BLE-MIOTY-LOCALISATION/Bluetooth-and-Mioty-Localization/README.md

This repository contains all the files related to research projects.
