BLE-MIOTY-LOCALISATION/Bluetooth-and-Mioty-Localization/NOTES.docx

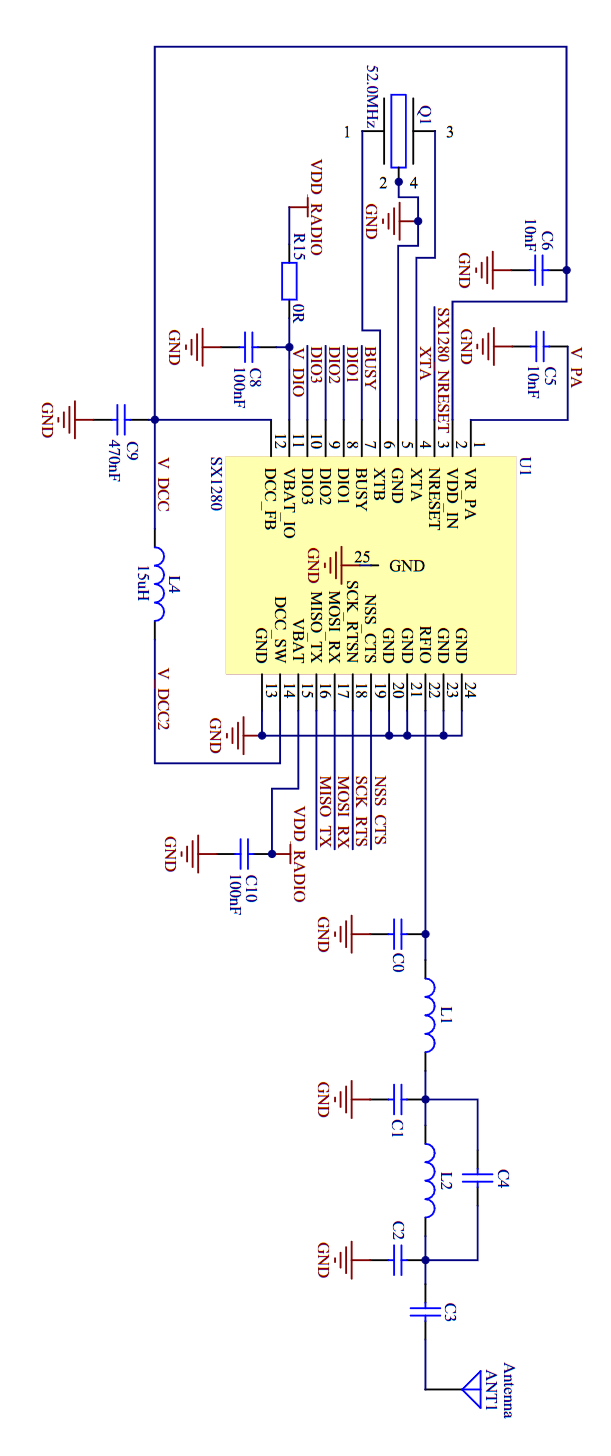
[picture p1: figure]
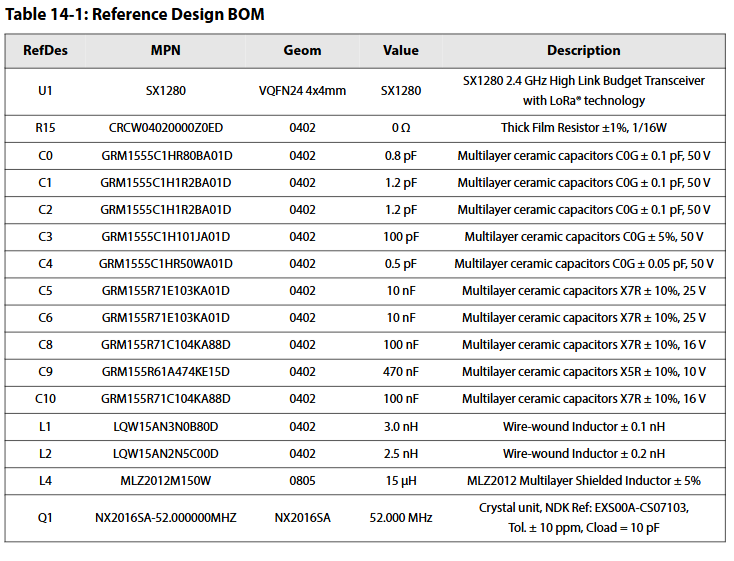
[picture p2: figure]
