BLE-MIOTY-LOCALISATION/Bluetooth-and-Mioty-Localization/BOM.xlsx

S. No. | Schematic No | Component | Details | Part number | URL | Price
Power Supply
1 | RB1 | Resistor | 20 | CRCW040220R0FKED | https://www.digikey.de/de/products/detail/vishay-dale/CRCW040220R0FKED/1177811
2 | U3 | CR2032 | Battery | CR2032 | https://www.digikey.de/de/products/detail/jauch-quartz/CR2032/13540138
Reset Mechanism
1 | R3 | Resistor | 10K | CRCW040210K0FKED | https://www.digikey.de/en/products/detail/vishay-dale/CRCW040210K0FKED/1178121
2 | C6 | Capacitor | 1u | C0402C105K8PACTU | https://www.digikey.de/en/products/detail/kemet/C0402C105K8PACTU/3471488
J Link
1 | C1 | Capacitor | 0.1u | CC0402KRX7R9BB104 | https://www.digikey.de/en/products/detail/yageo/CC0402KRX7R9BB104/5883371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
Oscillator
1 | Y1 | Crtystal Osc | 8MHx | ECS-80-12-33-JGN-TR | https://www.digikey.de/en/products/detail/ecs-inc/ECS-80-12-33-JGN-TR/10478769
2 | Y2 | Crtystal Osc | 32KHz | ABS07-32.768KHZ-7-T | https://www.digikey.de/en/products/detail/abracon-llc/abs07-32-768khz-7-t/1236859
3 | C2 | Capacitor | 24p | GRM1555C1H240GA01D | https://www.digikey.de/de/products/detail/murata-electronics/GRM1555C1H240GA01D/3693952
4 | C3 | Capacitor | 24p | GRM1555C1H240GA01D | https://www.digikey.de/de/products/detail/murata-electronics/GRM1555C1H240GA01D/3693952
5 | C4 | Capacitor | 14p | GJM1555C1H140GB01D | https://www.digikey.de/de/products/detail/murata-electronics/GJM1555C1H140GB01D/6606072
6 | C5 | Capacitor | 14p | GJM1555C1H140GB01D | https://www.digikey.de/de/products/detail/murata-electronics/GJM1555C1H140GB01D/6606072
LED
1 | R4 | Resistor | 2K | CRCW04022K00FKED | https://www.digikey.de/en/products/detail/vishay-dale/CRCW04022K00FKED/1178039
2 | D1 | LED | Blue | XL-1005UBC | https://www.digikey.de/en/products/detail/xinglight/XL-1005UBC/25673346
Microcontroller
1 | U3 | Microcontroller |  | STM32F103CBU6 | https://www.digikey.de/en/products/detail/stmicroelectronics/STM32F103CBU6/3087769
2 | R5 | Resistor | 100K | CRCW0402100KFKED | https://www.digikey.de/en/products/detail/vishay-dale/CRCW0402100KFKED/1178235
3 | C8 | Capacitor | 0.1u | CC0402KRX7R9BB104 | https://www.digikey.de/en/products/detail/yageo/CC0402KRX7R9BB104/5883371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
4 | C9 | Capacitor | 0.1u | CC0402KRX7R9BB104 | https://www.digikey.de/en/products/detail/yageo/CC0402KRX7R9BB104/5883371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
5 | C10 | Capacitor | 0.1u | CC0402KRX7R9BB104 | https://www.digikey.de/en/products/detail/yageo/CC0402KRX7R9BB104/5883371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
6 | C11 | Capacitor | 0.1u | CC0402KRX7R9BB104 | https://www.digikey.de/en/products/detail/yageo/CC0402KRX7R9BB104/5883371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
7 | C13 | Capacitor | 0.1u | CC0402KRX7R9BB104 | https://www.digikey.de/en/products/detail/yageo/CC0402KRX7R9BB104/5883371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
8 | C15 | Capacitor | 0.1u | CC0402KRX7R9BB104 | https://www.digikey.de/en/products/detail/yageo/CC0402KRX7R9BB104/5883371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
LoRa WAN Module
1 | XTAL1 | Crytal oscillator | 52M | CS06016-52M | https://www.digikey.de/de/products/detail/ndk-nihon-dempa-kogyo-co-ltd/CS06016-52M/9172036
2 | C17 | Capacitor | 10p | GRM1555C1H100FA01D | https://www.digikey.de/de/products/detail/murata-electronics/GRM1555C1H100FA01D/2543854
3 | C18 | Capacitor | 10p | GRM1555C1H100FA01D | https://www.digikey.de/de/products/detail/murata-electronics/GRM1555C1H100FA01D/2543854
4 | L3 | Inductor | 15u | MLZ2012M150W | https://www.digikey.de/en/products/detail/tdk-corporation/MLZ2012M150WT000/2465154
5 | C25 | Capacitor | 10n | GRM155R71E103KA01D | https://www.digikey.de/en/products/detail/murata-electronics/grm155r71e103ka01d/587223
6 | C27 | Capacitor | 100n | GRM155R71C104KA88D | https://www.digikey.de/en/products/detail/murata-electronics/GRM155R71C104KA88D/675947
7 | RZ1 | Resistor | 0n | CRCW04020000Z0ED | https://www.digikey.de/en/products/detail/vishay-dale/CRCW04020000Z0ED/1177495
8 | C32 | Capacitor | 100n | GRM155R71C104KA88D | https://www.digikey.de/en/products/detail/murata-electronics/GRM155R71C104KA88D/675947
9 | C30 | Capacitor | 10n | GRM155R71E103KA01D | https://www.digikey.de/en/products/detail/murata-electronics/grm155r71e103ka01d/587223
10 | C28 | Capacitor | 470n | GRM155R61A474KE15D | https://www.digikey.de/en/products/detail/murata-electronics/GRM155R61A474KE15D/702528
11 | U4 | Lora Wan |  | SX1280IMLTRT | https://www.digikey.de/en/products/detail/semtech-corporation/SX1280IMLTRT/7203797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
Antenna Frontend
1 | C19 | capacitor | 0.8p | GRM1555C1HR80BA01D | https://www.digikey.de/en/products/detail/murata-electronics/GRM1555C1HR80BA01D/3694062
2 | L1 | Inductor | 3n | LQW15AN3N0B80D | https://www.digikey.de/en/products/detail/murata-electronics/LQW15AN3N0B80D/4905926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
3 | C21 | capacitor | 1.2p | GRM1555C1H1R2BA01D | https://www.digikey.de/en/products/detail/murata-electronics/GRM1555C1H1R2BA01D/3693934
4 | C22 | capacitor | 0.5p | GRM1555C1HR50WA01D | https://www.digikey.de/en/products/detail/murata-electronics/GRM1555C1HR50WA01D/3694056
5 | L2 | Inductor | 2.5n | LQW15AN2N5C00D | https://www.digikey.de/en/products/detail/murata-electronics/LQW15AN2N5C00D/2594887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
6 | C23 | capacitor | 1.2p | GRM1555C1H1R2BA01D | https://www.digikey.de/en/products/detail/murata-electronics/GRM1555C1H1R2BA01D/3693934
7 | C26 | capacitor | 0
8 | J1 | Connector |  | CONMHF1-SMD-G-T | https://www.digikey.de/de/products/detail/te-connectivity-linx/CONMHF1-SMD-G-T/15293397?gclsrc=aw.ds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
9 | C28 | capacitor | 0
10 | C29 | capacitor | 0
Tantal Capacitor
1 | C10 | Tantal capacitor | 220u | T491D227K010AT | https://www.digikey.de/en/products/detail/kemet/T491D227K010AT/2336333
Accelerometer
1 | U5 | Accelerometer | ICM-45686 | ICM-45686 | https://www.digikey.de/de/products/detail/tdk-invensense/ICM-45686/24374985
2 | R6 | Resistor | 10K | CRCW040210K0FKED | https://www.digikey.de/en/products/detail/vishay-dale/CRCW040210K0FKED/1178121
3 | C16 | Capacitor | 0.1u | CC0402KRX7R9BB104 | https://www.digikey.de/en/products/detail/yageo/CC0402KRX7R9BB104/5883371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
4 | R7 | Resistor | 4.7K | CRCW04024K70FKED | https://www.digikey.de/de/products/detail/vishay-dale/CRCW04024K70FKED/1178083
5 | R8 | Resistor | 4.7K | CRCW04024K70FKED | https://www.digikey.de/de/products/detail/vishay-dale/CRCW04024K70FKED/1178083
6 | C31 | Capacitor | 0.1u | CC0402KRX7R9BB104 | https://www.digikey.de/en/products/detail/yageo/CC0402KRX7R9BB104/5883371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
Magnetometer
1 | U1 | Magnetometer | magnetoresistiv Sensor X, Y, Z Achse 12-LGA (2x2) | IIS2MDCTR | https://www.digikey.de/de/products/detail/stmicroelectronics/IIS2MDCTR/7927708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
2 | R1 | Resistor | 4.7K | CRCW04024K70FKED | https://www.digikey.de/de/products/detail/vishay-dale/CRCW04024K70FKED/1178083
3 | R2 | Resistor | 4.7K | CRCW04024K70FKED | https://www.digikey.de/de/products/detail/vishay-dale/CRCW04024K70FKED/1178083
4 | C7 | Capacitor | 220n | GRM155R71C224KA12D | https://www.digikey.de/de/products/detail/murata-electronics/GRM155R71C224KA12D/2175204
5 | C12 | Capacitor | 10u | GRM155R61A106ME11D | https://www.digikey.de/de/products/detail/murata-electronics/GRM155R61A106ME11D/12091056
6 | C14 | Capacitor | 0.1u | CC0402KRX7R9BB104 | https://www.digikey.de/en/products/detail/yageo/CC0402KRX7R9BB104/5883371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
