BLE-MIOTY-LOCALISATION/Bluetooth-and-Mioty-Localization/Datasheets/BATTERY Footprint/CR2032/CR2032.step

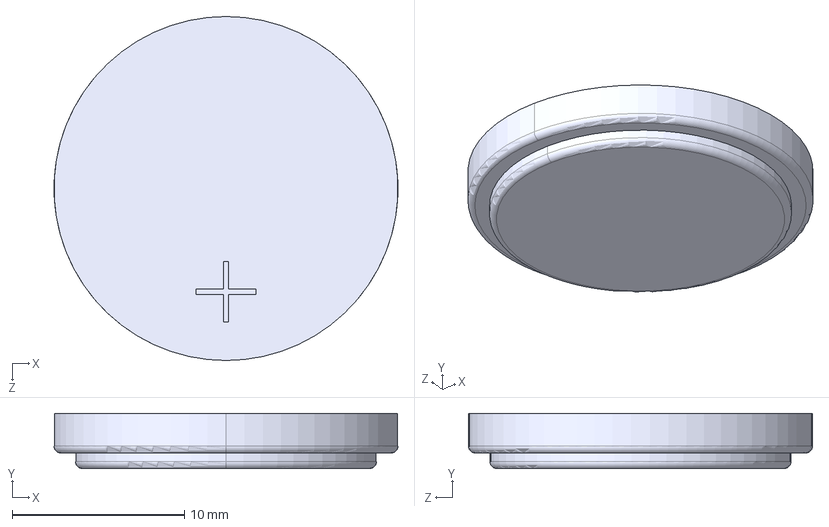
[picture p3: CAD file, 2025-08-18]
Datasheets/BATTERY Footprint/CR2032/CR2032.step
20.0 x 3.20 x 20.0 mm
