BLE-MIOTY-LOCALISATION/Bluetooth-and-Mioty-Localization/Datasheets/LORA_SX1280/SX1280IMLTRT Footprint/SX1280IMLTRT.step

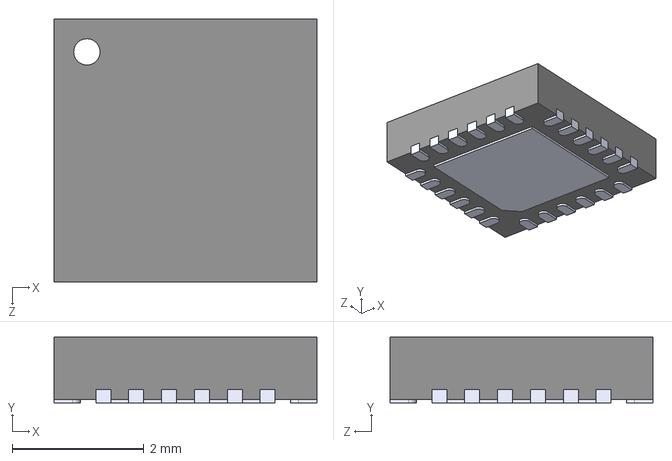
[picture p4: CAD file, 2025-08-18]
Datasheets/LORA_SX1280/SX1280IMLTRT Footprint/SX1280IMLTRT.step
4.00 x 1.00 x 4.00 mm
