BLE-MIOTY-LOCALISATION/Bluetooth-and-Mioty-Localization/KICAD/Footprints/ABM13W_52_0000MHZ_5_NH7U_T5/ABM13W-52.0000MHZ-5-NH7U-T5.step

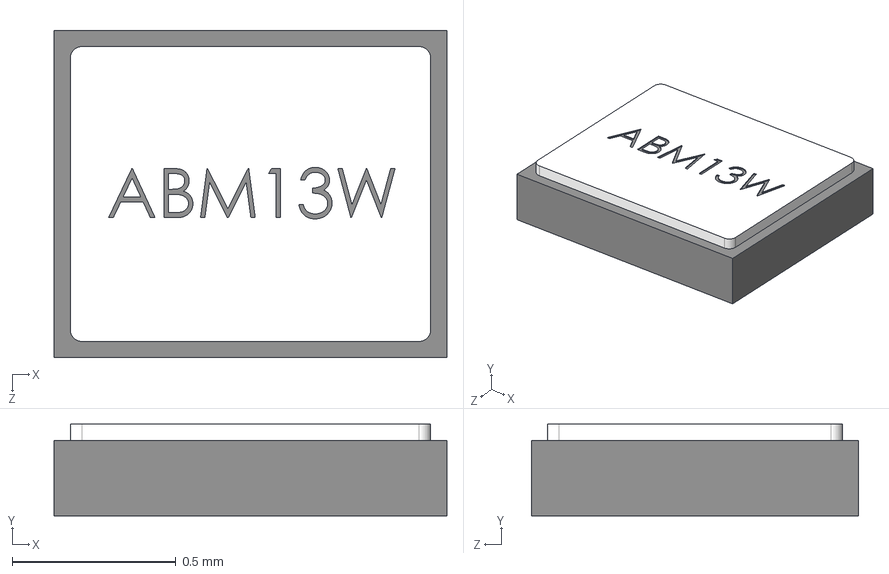
[picture p5: CAD file, 2025-10-31]
KICAD/Footprints/ABM13W_52_0000MHZ_5_NH7U_T5/ABM13W-52.0000MHZ-5-NH7U-T5.step
1.20 x 0.28 x 1.00 mm
