BLE-MIOTY-LOCALISATION/Bluetooth-and-Mioty-Localization/KICAD/Footprints/ABS07_32_768KHZ_7_T/ABS07-32.768KHZ-7-T.step

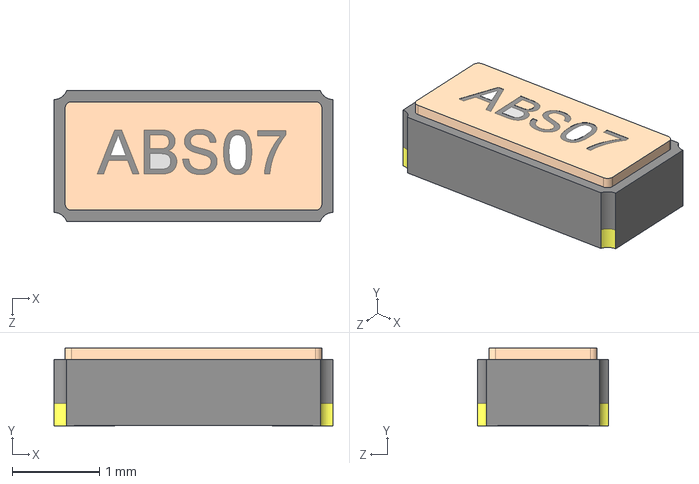
[picture p6: CAD file, 2025-10-17]
KICAD/Footprints/ABS07_32_768KHZ_7_T/ABS07-32.768KHZ-7-T.step
3.20 x 0.889 x 1.50 mm
