BLE-MIOTY-LOCALISATION/Bluetooth-and-Mioty-Localization/KICAD/Footprints/ICM_45686/ICM-45686.step

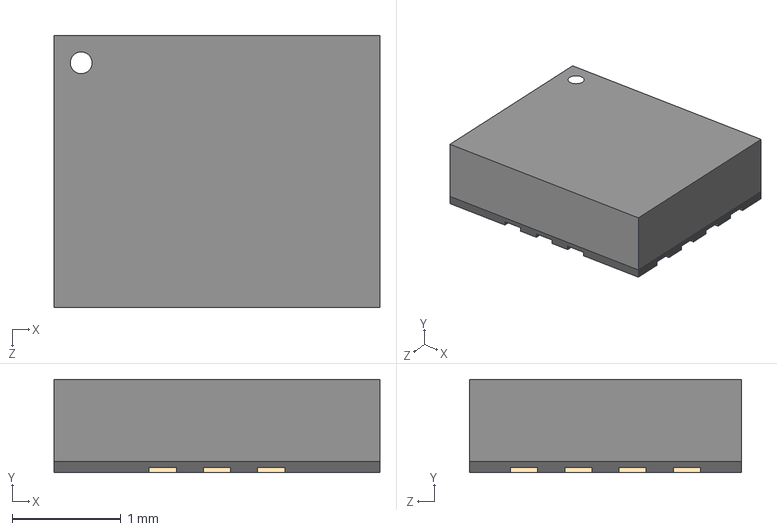
[picture p7: CAD file, 2025-10-23]
KICAD/Footprints/ICM_45686/ICM-45686.step
3.00 x 0.86 x 2.50 mm
