BLE-MIOTY-LOCALISATION/Bluetooth-and-Mioty-Localization/Documentations/schematic.pdf

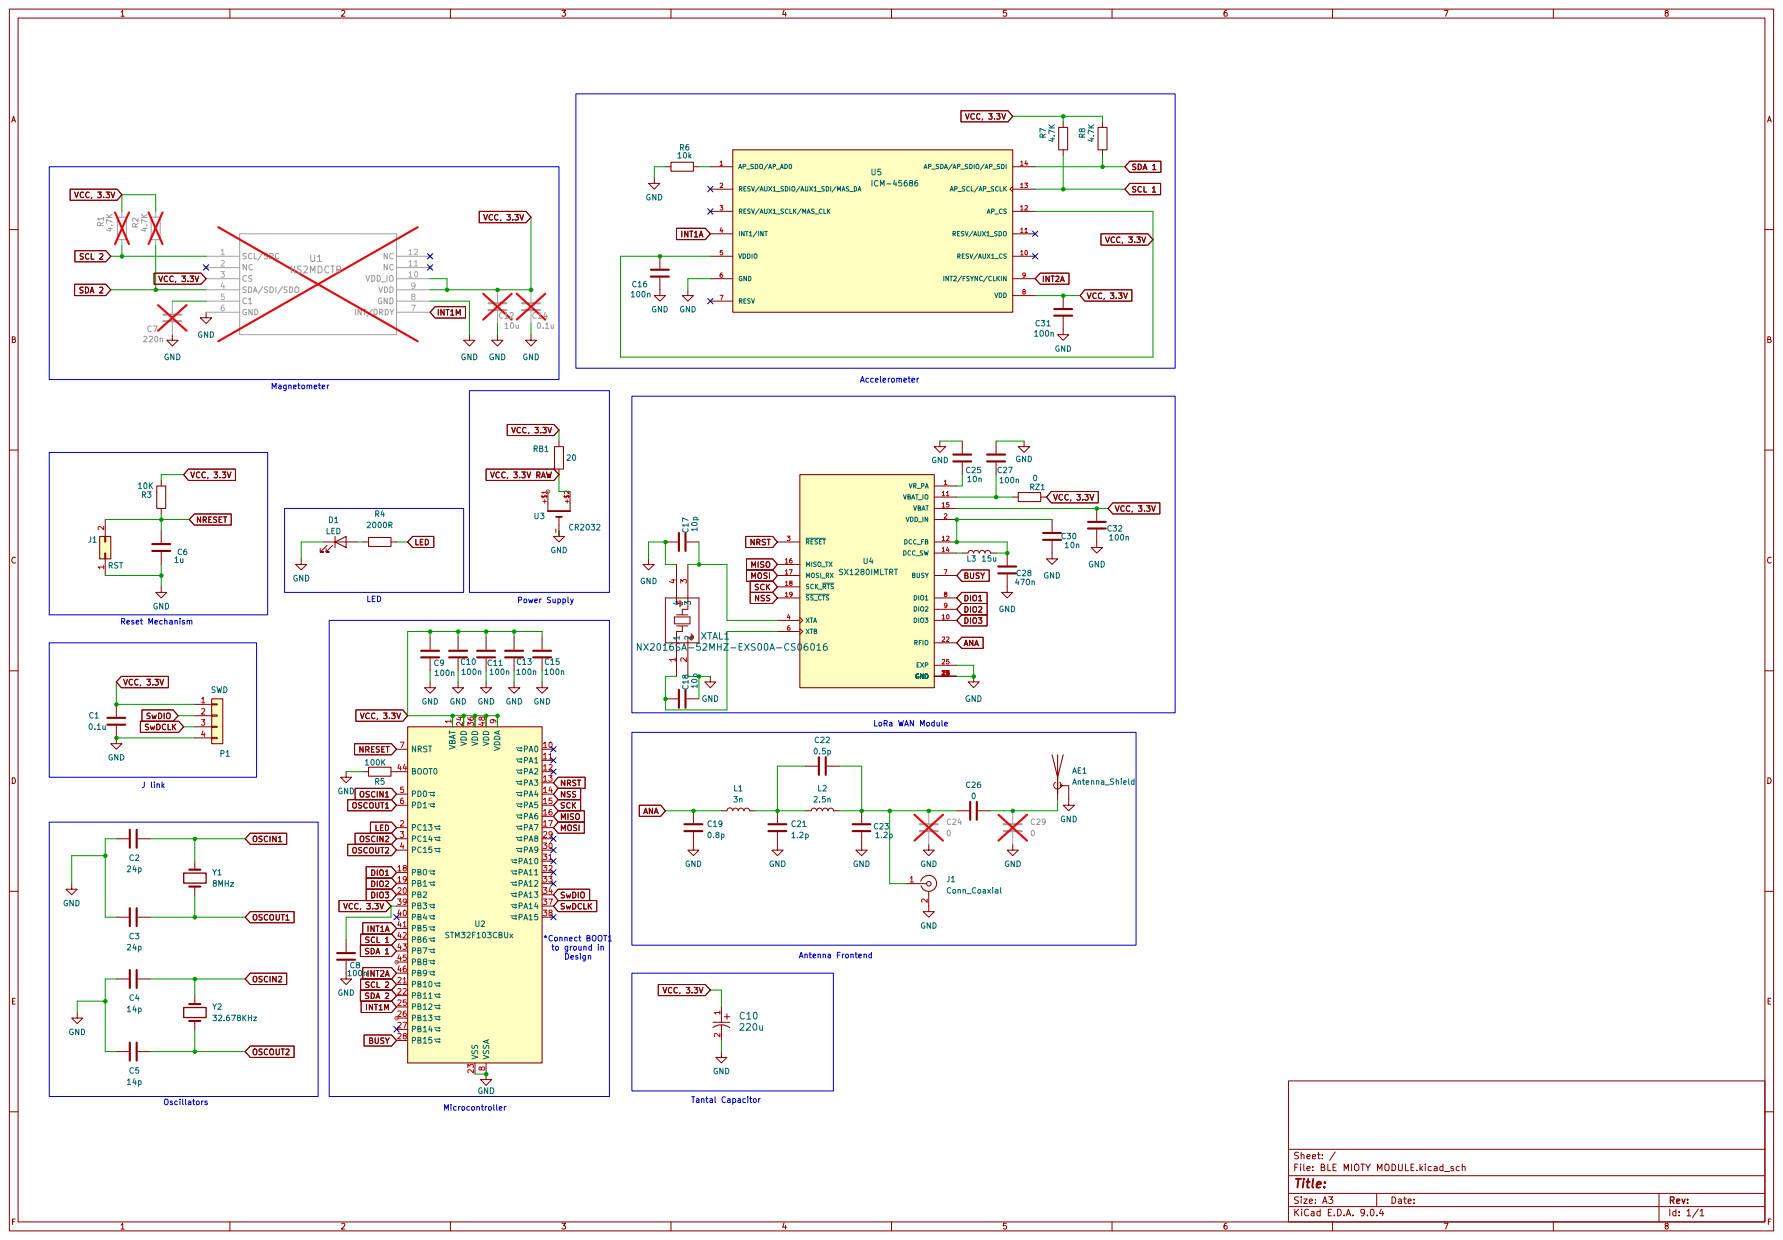
[picture p8: page 1]
