BLE-MIOTY-LOCALISATION/Bluetooth-and-Mioty-Localization/KICAD/BLE_MIOTY_MODULE/BLE MIOTY MODULE.kicad_pcb

## KiCad design KICAD/BLE_MIOTY_MODULE/BLE MIOTY MODULE.kicad_pcb (2025-12-04)

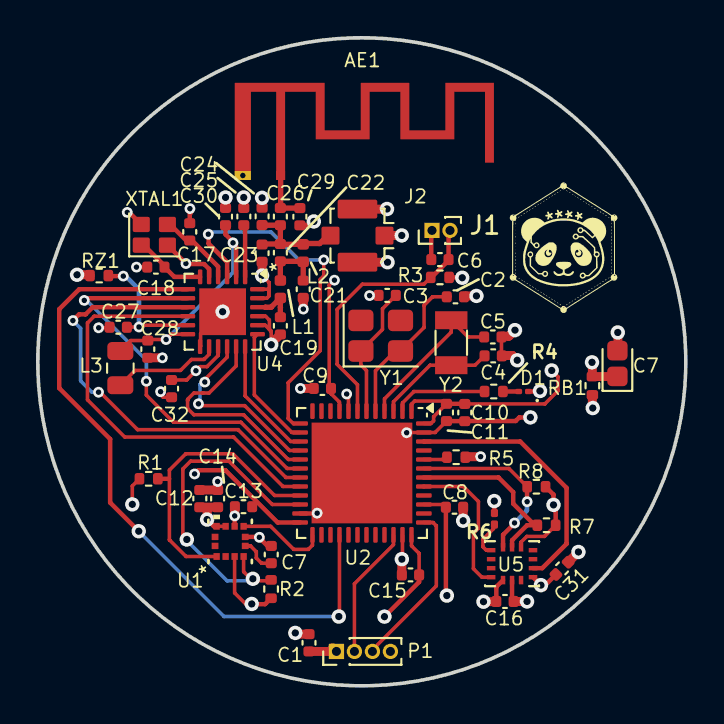
[picture p9: board BLE MIOTY MODULE.kicad_pcb from above]

Board: 4 copper layers, 36.0 x 36.0 mm, 58 parts (1 on the bottom side), 41 nets.

Parts:
AE1: Antenna_Shield; Texas_SWRA117D_2.4GHz_Right
C1, C14: 0.1u; C_0402_1005Metric
C2, C3: 24p; C_0402_1005Metric
C4, C5: 14p; C_0402_1005Metric
C6: 1u; C_0402_1005Metric
C7: 220n; C_0402_1005Metric
C7#2: CP_EIA-1608-08_AVX-J
C8, C9, C10, C11, C13, C15, C16, C27, C31, C32: 100n; C_0402_1005Metric
C12: 10u; C_0402_1005Metric
C17, C18: 10p; C_0402_1005Metric
C19: 0.8p; C_0402_1005Metric
C21, C23: 1.2p; C_0402_1005Metric
C22: 0.5p; C_0402_1005Metric
C24, C26, C29: 0; C_0402_1005Metric
C25, C30: 10n; C_0402_1005Metric
C28: 470n; C_0402_1005Metric
D1: LED; LED_01005_0402Metric
J1: RST; PinHeader_1x02_P1.00mm_Vertical
J2: Conn_Coaxial; U.FL_Molex_MCRF_73412-0110_Vertical
L1: 3n; L_0402_1005Metric
L2: 2.5n; L_0402_1005Metric
L3: 15u; C_0805_2012Metric
P1: SWD; PinHeader_1x04_P1.00mm_Vertical
R1, R2, R7, R8: 4.7K; R_0402_1005Metric
R3: 10K; R_0402_1005Metric
R4: 2000R; R_0402_1005Metric
R5: 100K; R_0402_1005Metric
R6: 10k; R_0201_0603Metric
RB1: 20; R_0402_1005Metric
RZ1: R; R_0402_1005Metric
U1: IIS2MDCTR; LGA-12_2X2X0P7_STM
U2: STM32F103CBUx; QFN-48-1EP_7x7mm_P0.5mm_EP5.6x5.6mm
U3: CR2032; BatteryHolder_Keystone_3002_1x2032
U4: SX1280IMLTRT; QFN-24-1EP_4x4mm_P0.5mm_EP2.6x2.6mm
U5: ICM-45686; IC_ICM-45686
XTAL1: NX2016SA-52MHZ-EXS00A-CS06016; Crystal_SMD_SeikoEpson_FA128-4Pin_2.0x1.6mm
Y1: 8MHz; Crystal_SMD_3225-4Pin_3.2x2.5mm
Y2: 32.678KHz; Crystal_SMD_3215-2Pin_3.2x1.5mm

Connections:
ANA: C19.2, L1.1, U4.22 (RFIO)
BUSY: U2.28 (PB15), U4.7 (BUSY)
DIO1: U2.18 (PB0), U4.8 (DIO1)
DIO2: U2.19 (PB1), U4.9 (DIO2)
DIO3: U2.20 (PB2), U4.10 (DIO3)
GND: AE1.2 (Shield), C1.1, C2.1, C3.1, C4.1, C5.1, C6.2, C7.2, C7#2.2, C8.2, C9.2, C10.2, C11.2, C12.2, C13.2, C14.2, C15.2, C16.2, C17.1, C18.2, C19.1, C21.1, C23.2, C24.2, C25.2, C27.2, C28.2, C29.2, C30.1, C31.2, C32.1, D1.1 (K), J1.1, J2.2 (Ext), P1.4, R5.2, R6.2, U1.6 (GND), U1.8 (GND), U2.8 (VSSA), U2.23 (VSS), U2.35 (VSS), U2.47 (VSS), U2.49 (VSS), U3.2, U4.5 (GND), U4.13 (GND), U4.20 (GND), U4.21 (GND), U4.23 (GND), U4.24 (GND), U4.25 (EXP), U5.6 (GND), XTAL1.2, XTAL1.4
INT1A: U2.41 (PB5), U5.4 (INT1/INT)
INT1M: U1.7 (INT/DRDY), U2.25 (PB12)
INT2A: U2.46 (PB9), U5.9 (INT2/FSYNC/CLKIN)
LED: R4.2, U2.2 (PC13)
MISO: U2.16 (PA6), U4.16 (MISO_TX)
MOSI: U2.17 (PA7), U4.17 (MOSI_RX)
NRESET: C6.1, J1.2, R3.2, U2.7 (NRST)
NRST: U2.13 (PA3), U4.3 (~RESET)
NSS: U2.14 (PA4), U4.19 (~SS_CTS)
unnamed: AE1.1 (A), C26.1, C29.1
unnamed: C21.2, C22.2, L1.2, L2.1
unnamed: D1.2 (A), R4.1
unnamed: C22.1, C23.1, C24.1, C26.2, J2.1 (In), L2.2
unnamed: C7.1, U1.5 (C1)
unnamed: R5.1, U2.44 (BOOT0)
unnamed: C28.1, C30.2, L3.2, U4.2 (VDD_IN), U4.12 (DCC_FB)
unnamed: L3.1, U4.14 (DCC_SW)
unnamed: C27.1, RZ1.2, U4.11 (VBAT_IO)
unnamed: C25.1, U4.1 (VR_PA)
unnamed: C17.2, U4.4 (XTA), XTAL1.3
unnamed: C18.1, U4.6 (XTB), XTAL1.1
unnamed: R6.1, U5.1 (AP_SDO/AP_AD0)
OSCIN1: C2.2, U2.5 (PD0), Y1.2
OSCIN2: C4.2, U2.3 (PC14), Y2.2
OSCOUT1: C3.2, U2.6 (PD1), Y1.1
OSCOUT2: C5.2, U2.4 (PC15), Y2.1
SCK: U2.15 (PA5), U4.18 (SCK_~RTS)
SCL 1: R7.2, U2.42 (PB6), U5.13 (AP_SCL/AP_SCLK)
SCL 2: R1.2, U1.1 (SCL/SPC), U2.21 (PB10)
SDA 1: R8.1, U2.43 (PB7), U5.14 (AP_SDA/AP_SDIO/AP_SDI)
SDA 2: R2.2, U1.4 (SDA/SDI/SDO), U2.22 (PB11)
SwDCLK: P1.3, U2.37 (PA14)
SwDIO: P1.2, U2.34 (PA13)
VCC, 3.3V: C1.2, C7#2.1, C8.1, C9.1, C10.1, C11.1, C12.1, C13.1, C14.1, C15.1, C16.1, C31.1, C32.2, P1.1, R1.1, R2.1, R3.1, R7.1, R8.2, RB1.1, RZ1.1, U1.3 (CS), U1.9 (VDD), U1.10 (VDD_IO), U2.1 (VBAT), U2.9 (VDDA), U2.24 (VDD), U2.36 (VDD), U2.39 (PB3), U2.48 (VDD), U4.15 (VBAT), U5.5 (VDDIO), U5.8 (VDD), U5.12 (AP_CS)
VCC, 3.3V RAW: RB1.2, U3.1
