BLE-MIOTY-LOCALISATION/Bluetooth-and-Mioty-Localization/Phase 1 - Hardware Design/KiCad Design/RP Pico TX 2.4.kicad_sch

## KiCad design Phase 1 - Hardware Design/KiCad Design/RP Pico TX 2.4.kicad_sch (2025-08-15)

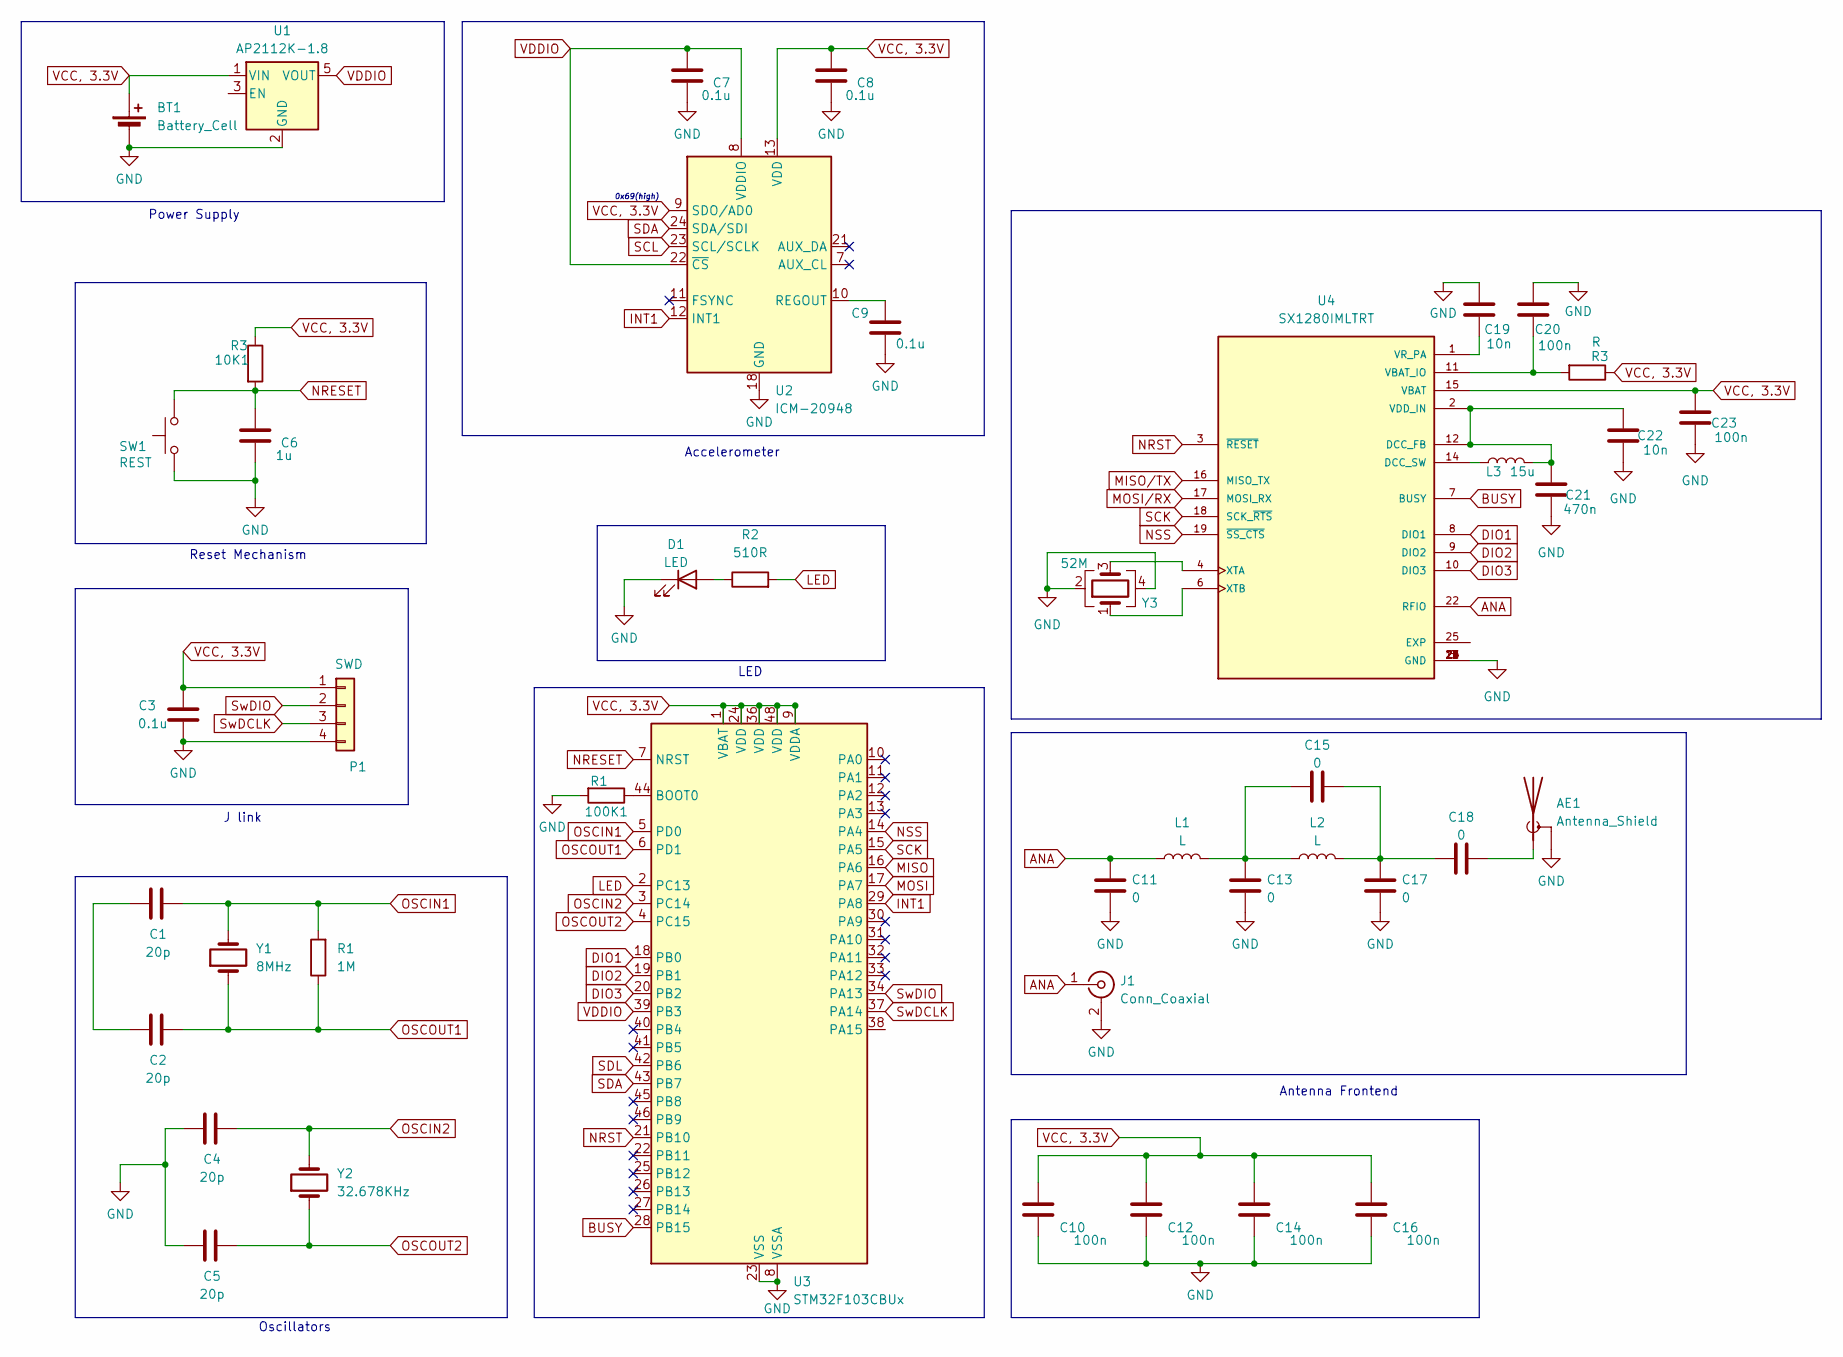
[picture p10: schematic RP Pico TX 2.4.kicad_sch]

Parts:
10K1: R3
100K1: R1
AE1: Antenna_Shield; Texas_SWRA117D_2.4GHz_Right
BT1: Battery_Cell
C1, C2, C4, C5: 20p; C_0805_2012Metric_Pad1.18x1.45mm_HandSolder
C3, C7, C8, C9: 0.1u
C6: 1u
C10, C12, C14, C16: 100n; C_0805_2012Metric_Pad1.18x1.45mm_HandSolder
C11, C13, C15, C17, C18: 0; C_0805_2012Metric_Pad1.18x1.45mm_HandSolder
C19, C22: 10n
C20, C23: 100n
C21: 470n
D1: LED; LED_0805_2012Metric_Pad1.15x1.40mm_HandSolder
J1: Conn_Coaxial; U.FL_Molex_MCRF_73412-0110_Vertical
L1, L2: L
L3: 15u
P1: SWD
R1: 1M; R_0805_2012Metric_Pad1.20x1.40mm_HandSolder
R2: 510R; R_0805_2012Metric_Pad1.20x1.40mm_HandSolder
R3: R
SW1: REST; SW_SPST_Omron_B3FS-100xP
U1: AP2112K-1.8; SOT-23-5
U2: ICM-20948; InvenSense_QFN-24_3x3mm_P0.4mm
U3: STM32F103CBUx; QFN-48-1EP_7x7mm_P0.5mm_EP5.6x5.6mm
U4: SX1280IMLTRT; QFN-24-1EP_4x4mm_P0.5mm_EP2.6x2.6mm; PARTREV 3.3
Y1: 8MHz
Y2: 32.678KHz
Y3: 52M

Connections:
ANA: C11.2, J1.1 (In), L1.1, U4.22 (RFIO)
BUSY: U3.28 (PB15), U4.7 (BUSY)
DIO1: U3.18 (PB0), U4.8 (DIO1)
DIO2: U3.19 (PB1), U4.9 (DIO2)
DIO3: U3.20 (PB2), U4.10 (DIO3)
GND: 100K1.2, AE1.2 (Shield), BT1.2 (-), C3.1, C4.1, C5.1, C6.2, C7.2, C8.2, C9.1, C10.2, C11.1, C12.2, C13.1, C14.2, C16.2, C17.2, C19.2, C20.2, C21.2, C22.1, C23.1, D1.1 (K), J1.2 (Ext), P1.4, SW1.1, U1.2 (GND), U2.18 (GND), U2.20 (GND), U3.8 (VSSA), U3.23 (VSS), U3.35 (VSS), U3.47 (VSS), U3.49 (VSS), U4.5 (GND), U4.13 (GND), U4.20 (GND), U4.21 (GND), U4.23 (GND), U4.24 (GND), Y3.2, Y3.4
INT1: U2.12 (INT1), U3.29 (PA8)
LED: R2.2, U3.2 (PC13)
MISO: U3.16 (PA6)
MISO/TX: U4.16 (MISO_TX)
MOSI: U3.17 (PA7)
MOSI/RX: U4.17 (MOSI_RX)
NRESET: 10K1.2, C6.1, SW1.2, U3.7 (NRST)
NRST: U3.21 (PB10), U4.3 (~RESET)
NSS: U3.14 (PA4), U4.19 (~SS_CTS)
unnamed: 100K1.1, U3.44 (BOOT0)
unnamed: AE1.1 (A), C18.1
unnamed: C1.1, C2.1
unnamed: C9.2, U2.10 (REGOUT)
unnamed: C13.2, C15.2, L1.2, L2.1
unnamed: C15.1, C17.1, C18.2, L2.2
unnamed: C19.1, U4.1 (VR_PA)
unnamed: C20.1, R3.2, U4.11 (VBAT_IO)
unnamed: C21.1, C22.2, L3.2, U4.2 (VDD_IN), U4.12 (DCC_FB)
unnamed: D1.2 (A), R2.1
unnamed: L3.1, U4.14 (DCC_SW)
unnamed: U4.4 (XTA), Y3.3
unnamed: U4.6 (XTB), Y3.1
OSCIN1: C1.2, R1.2, U3.5 (PD0), Y1.2
OSCIN2: C4.2, U3.3 (PC14), Y2.2
OSCOUT1: C2.2, R1.1, U3.6 (PD1), Y1.1
OSCOUT2: C5.2, U3.4 (PC15), Y2.1
SCK: U3.15 (PA5), U4.18 (SCK_~RTS)
SCL: U2.23 (SCL/SCLK)
SDA: U2.24 (SDA/SDI), U3.43 (PB7)
SDL: U3.42 (PB6)
SwDCLK: P1.3, U3.37 (PA14)
SwDIO: P1.2, U3.34 (PA13)
VCC, 3.3V: 10K1.1, BT1.1 (+), C3.2, C8.1, C10.1, C12.1, C14.1, C16.1, C23.2, P1.1, R3.1, U1.1 (VIN), U2.9 (SDO/AD0), U2.13 (VDD), U3.1 (VBAT), U3.9 (VDDA), U3.24 (VDD), U3.36 (VDD), U3.48 (VDD), U4.15 (VBAT)
VDDIO: C7.1, U1.5 (VOUT), U2.8 (VDDIO), U2.22 (~CS), U3.39 (PB3)

Notes on the sheet:
Oscillators
J link
Antenna Frontend
Power Supply
0x69(high)
Accelerometer
Reset Mechanism
LED
