BLE-MIOTY-LOCALISATION/Bluetooth-and-Mioty-Localization/(commit log)

2025-07-01 Previous Project Injection
    [RP Pico TX 2.4-B_Cu.gbr, RP Pico TX 2.4-B_Mask.gbr, RP Pico TX 2.4-B_Paste.gbr, RP Pico TX 2.4-B_Silkscreen.gbr, RP Pico TX 2.4-Edge_Cuts.gbr, RP Pico TX 2.4-F_Cu.gbr, RP Pico TX 2.4-F_Mask.gbr, RP Pico TX 2.4-F_Paste.gbr]
2025-07-01 Progress 1
    [RP Pico TX 2.4.kicad_pcb, RP Pico TX 2.4.kicad_sch]
2025-08-15 updated kicad design and bluepill schematic files
    [RP Pico TX 2.4.kicad_sch]
2025-08-15 Added CR2032, start with PCB schematic
    [BLE MIOTY MODULE.kicad_pcb, BLE MIOTY MODULE.kicad_sch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]
2025-08-15 Did something
    [BLE MIOTY MODULE.kicad_sch]
2025-08-18 Updated Repo Structure, updated schematic v1.1
    [BLE MIOTY MODULE.kicad_pcb, BLE MIOTY MODULE.kicad_sch, BLE MIOTY MODULE_v2.kicad_sch, CR2032.step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]
2025-08-20 Updated PCB Design
    [BLE MIOTY MODULE.kicad_pcb, BLE MIOTY MODULE.kicad_sch]
2025-09-03 latest with lad9s1 acc and tantal
    [BLE MIOTY MODULE_v2.kicad_pcb]
2025-09-03 Updated latest with all files
    [BLE MIOTY MODULE.kicad_pcb, BLE MIOTY MODULE.kicad_sch, BLE MIOTY MODULE_v2.kicad_sch]
2025-09-11 Updated components acording to BOM
    [BLE MIOTY MODULE_v2.kicad_sch]
2025-10-14 New Beginings
    [BLE MIOTY MODULE.kicad_pcb, BLE MIOTY MODULE.kicad_sch, BLE MIOTY MODULE_v2.kicad_pcb, BLE MIOTY MODULE_v2.kicad_sch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]
2025-10-14 Some more
    [BLE MIOTY MODULE.kicad_sch]
2025-10-16 updated Link in BOM
    [BOM.xlsx]
2025-10-16 Added 5 Caps, Excel changes
    [BLE MIOTY MODULE.kicad_sch]
2025-10-16 Y3 Tental Pending, Start PCB, BOM Updated
    [BLE MIOTY MODULE.kicad_pcb]
2025-10-17 latest push
    [BLE MIOTY MODULE.kicad_pcb]
2025-10-17 PCB Premier League
    [BLE MIOTY MODULE.kicad_pcb, BLE MIOTY MODULE.kicad_sch, BOM.xlsx, CR2032.step, SX1280IMLTRT.step]
2025-10-17 RCBavaria First Push
    [ABS07-32.768KHZ-7-T.step, BLE MIOTY MODULE.kicad_pcb, BLE MIOTY MODULE.kicad_sch, BOM.xlsx]
2025-10-23 Fresh PCB start
    [BLE MIOTY MODULE.kicad_pcb, BLE MIOTY MODULE.kicad_sch]
2025-10-23 RC: Added Footprints Folder, Added New IMUs Sym/ Footprint
    [ABS07-32.768KHZ-7-T.step, BLE MIOTY MODULE.kicad_pcb, BLE MIOTY MODULE.kicad_sch, CR2032.step, ICM-45686.step, SX1280IMLTRT.step]
2025-10-23 STM ref
    [BLE MIOTY MODULE.kicad_sch]
2025-10-23 first proto
    [BLE MIOTY MODULE.kicad_pcb, BLE MIOTY MODULE.kicad_sch]
2025-10-27 new design on main
    [BLE MIOTY MODULE.kicad_pcb, BLE MIOTY MODULE.kicad_sch]
2025-10-27 minor change
    [BLE MIOTY MODULE.kicad_pcb]
2025-10-31 sync 2
    [BLE MIOTY MODULE.kicad_pcb, BLE MIOTY MODULE.kicad_sch]
2025-10-31 Sync 3
    [BLE MIOTY MODULE.kicad_pcb]
2025-11-05 final push
    updated BOM and PCB
    [BLE MIOTY MODULE.kicad_pcb, BLE MIOTY MODULE.kicad_sch, BOM.xlsx]
2025-12-03 Latest changes with 0 errors effective
    [BLE MIOTY MODULE.kicad_pcb]
2025-12-03 change of track width required
    [BLE MIOTY MODULE.kicad_pcb]
2025-12-04 Final Design for Production
    [BLE MIOTY MODULE.kicad_pcb]
2025-12-11 sync with BOM
    [BLE MIOTY MODULE.kicad_sch, BOM.xlsx]
2026-05-21 pin update
2026-05-27 Clean Up
    [ABM13W-52.0000MHZ-5-NH7U-T5.step, ABS07-32.768KHZ-7-T.step, BLE MIOTY MODULE.kicad_pcb, BLE MIOTY MODULE.kicad_sch, BOM.xlsx, CR2032.step, ICM-45686.step, SX1280IMLTRT.step]
2026-06-25 feat(power-opt): fix compilation, enable LSE/Low-power loop, and correct LED polarity
    - Fix compilation by declaring volatile 'alarm_fired' flag.
    - Populate empty main loop with BLE beacon transmission and Stop Mode entry.
    - Configure LORA_NRST (PA3) as GPIO output to prevent floating radio reset states.
    - Correct LED pin mapping for active-high polarity to eliminate sleep current leakage.
    - Switch RTC clock source to LSE (32.768 kHz) with a 32767 prescaler for accurate 1 Hz wakeup.
    - Add RSF flag synchronization to RTC_SetAlarm_1s() to prevent corrupted register reads after Stop Mode wakeup.
    - Create 25_06.md documenting implementation details and antenna path diagnostics.
    [main.c]
